CarlosQuijada211/CNC-Homemade-Writing-Machine/(commit log)

2025-07-21 Uploaded circuit and frame diagrams
2025-07-22 Uploaded arduino files
2025-07-24 Added python files.
    Uploaded custom python scripts along with gcode and processed instruction samples.
